TURBOyan/Turbo_Ctrl/README.md

## 1、开源仓库地址

	https://github.com/TURBOyan/Turbo_Ctrl.git
