TURBOyan/Turbo_Ctrl/2-Hardware/TurboCtrl_PCB/output/V1.2.0/TurboCtrl-v1.2.0.pdf

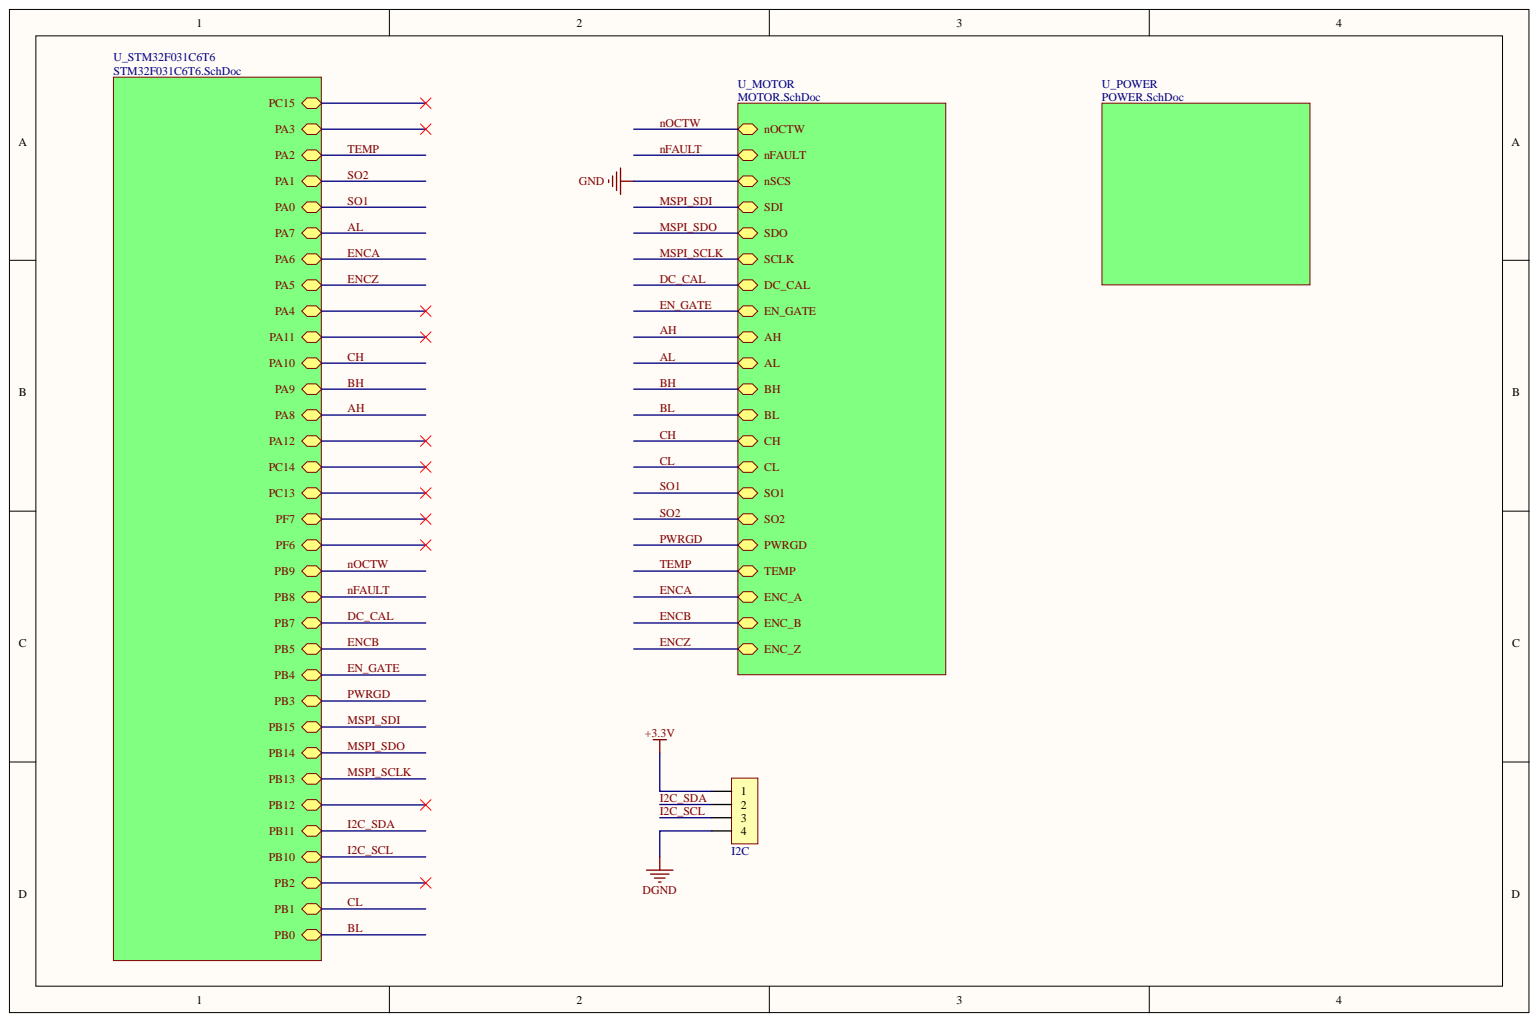
[picture p1: page 1]

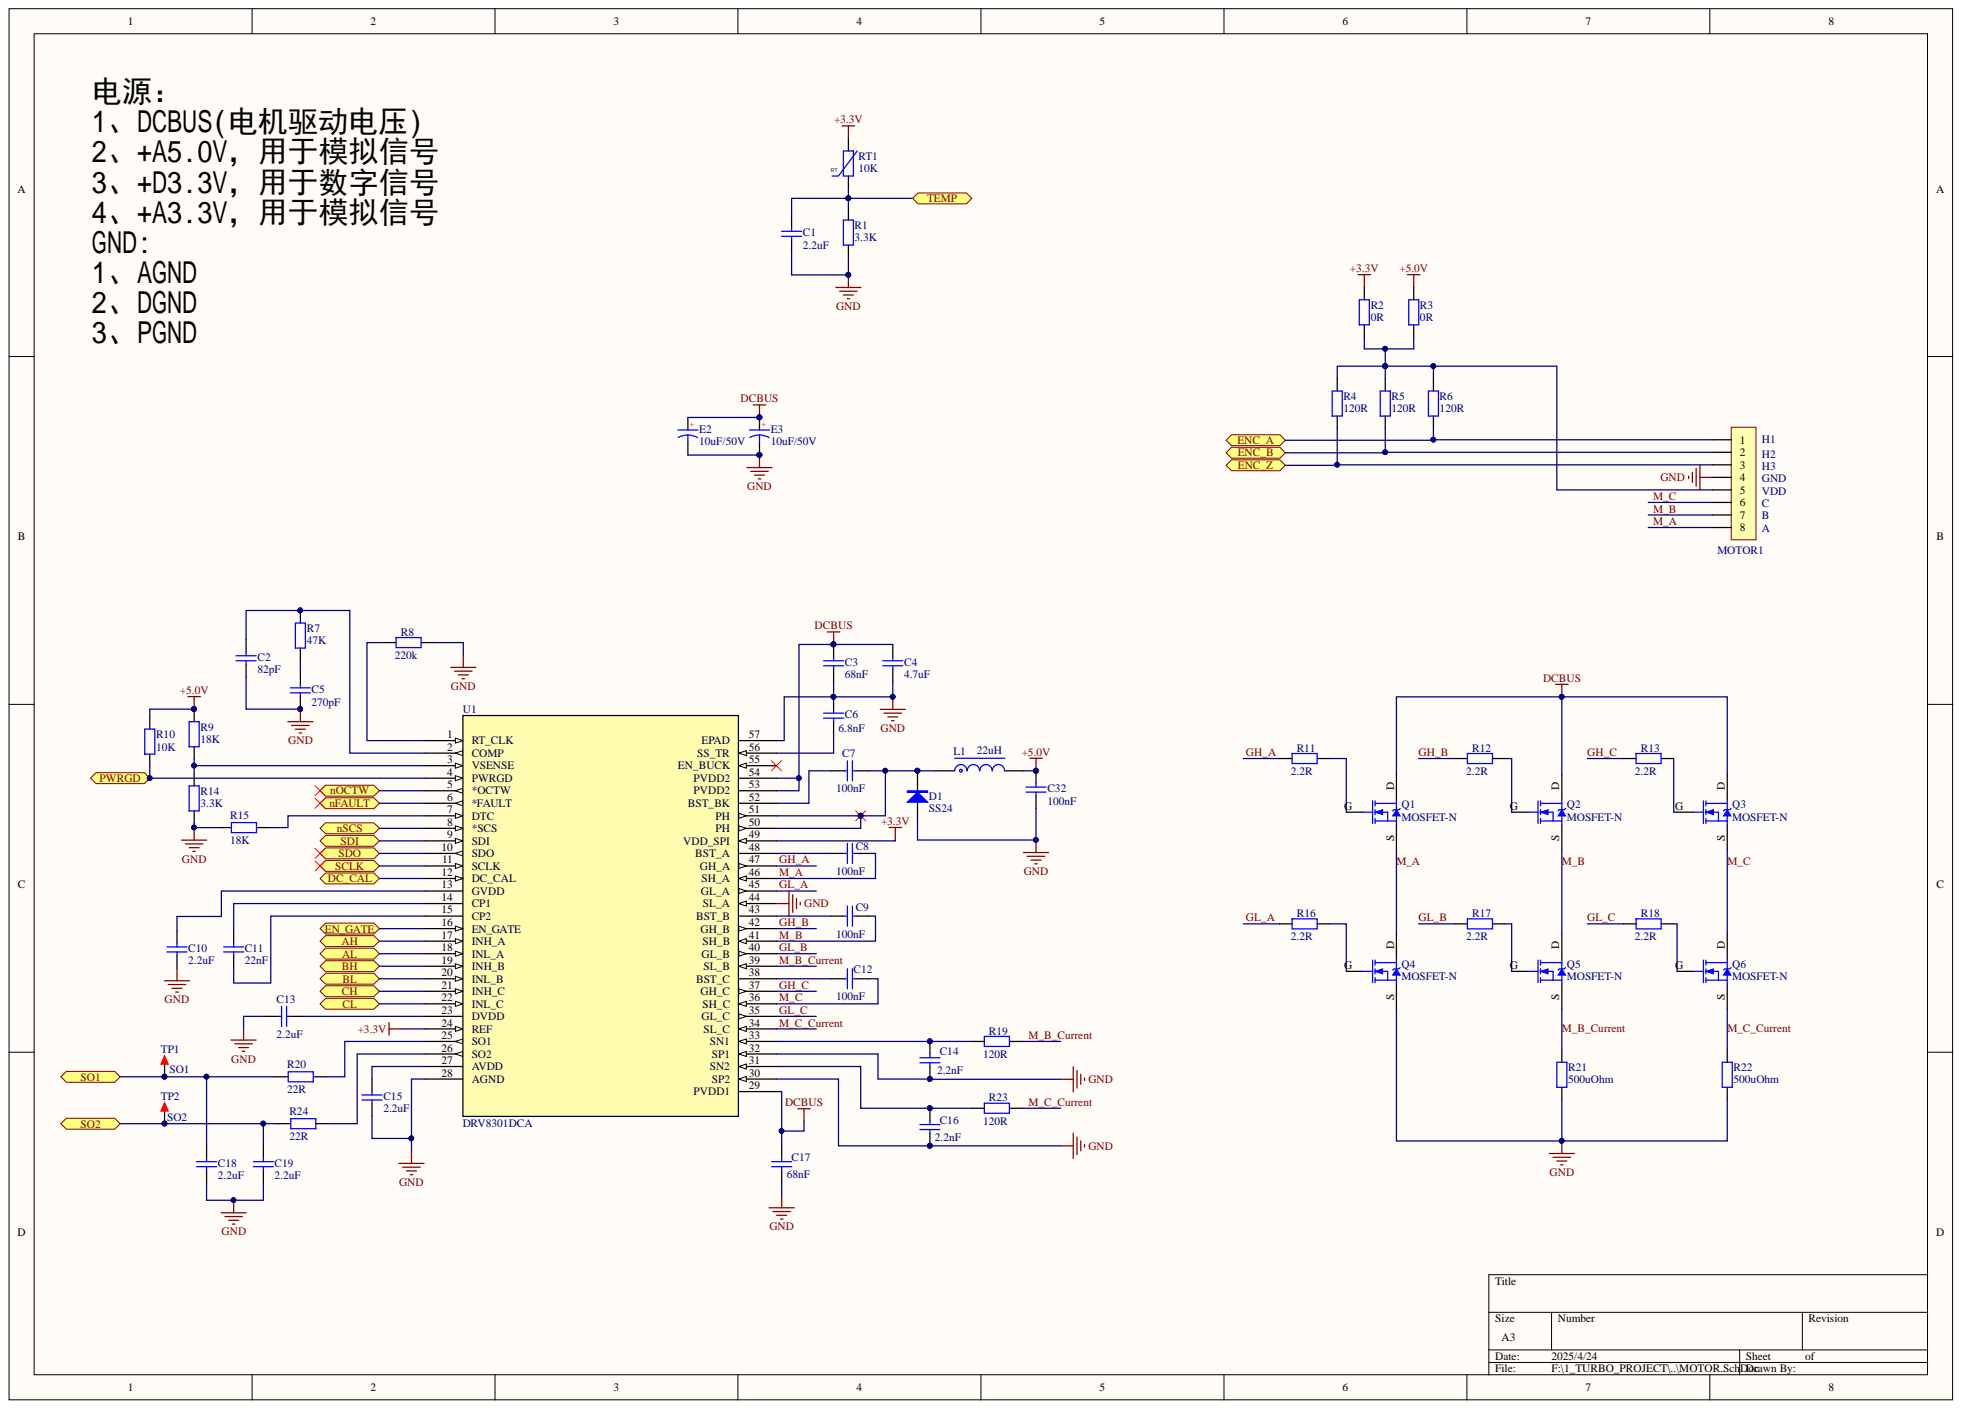
[picture p2: page 2]

SDO 10 | | C8

GVDD 13 | GL_A

SO2 26 AVDD 27

AGND 28 | 2.2nF

ECT\..\MOTOR.SchDoc Drawn By:

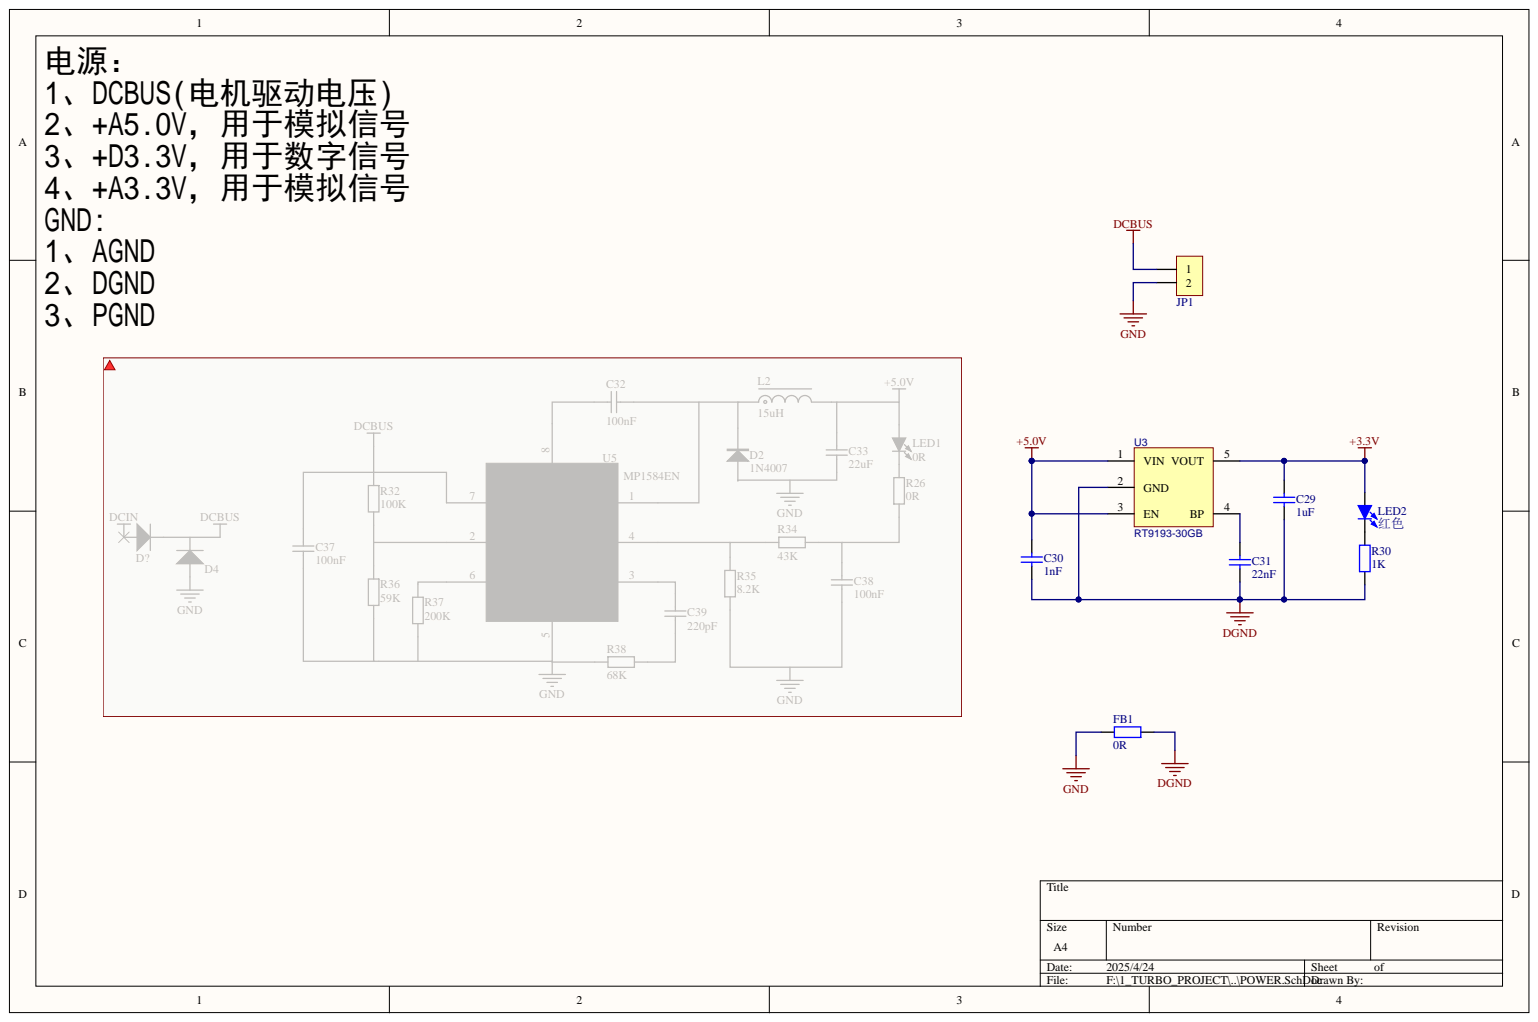
[picture p3: page 3]

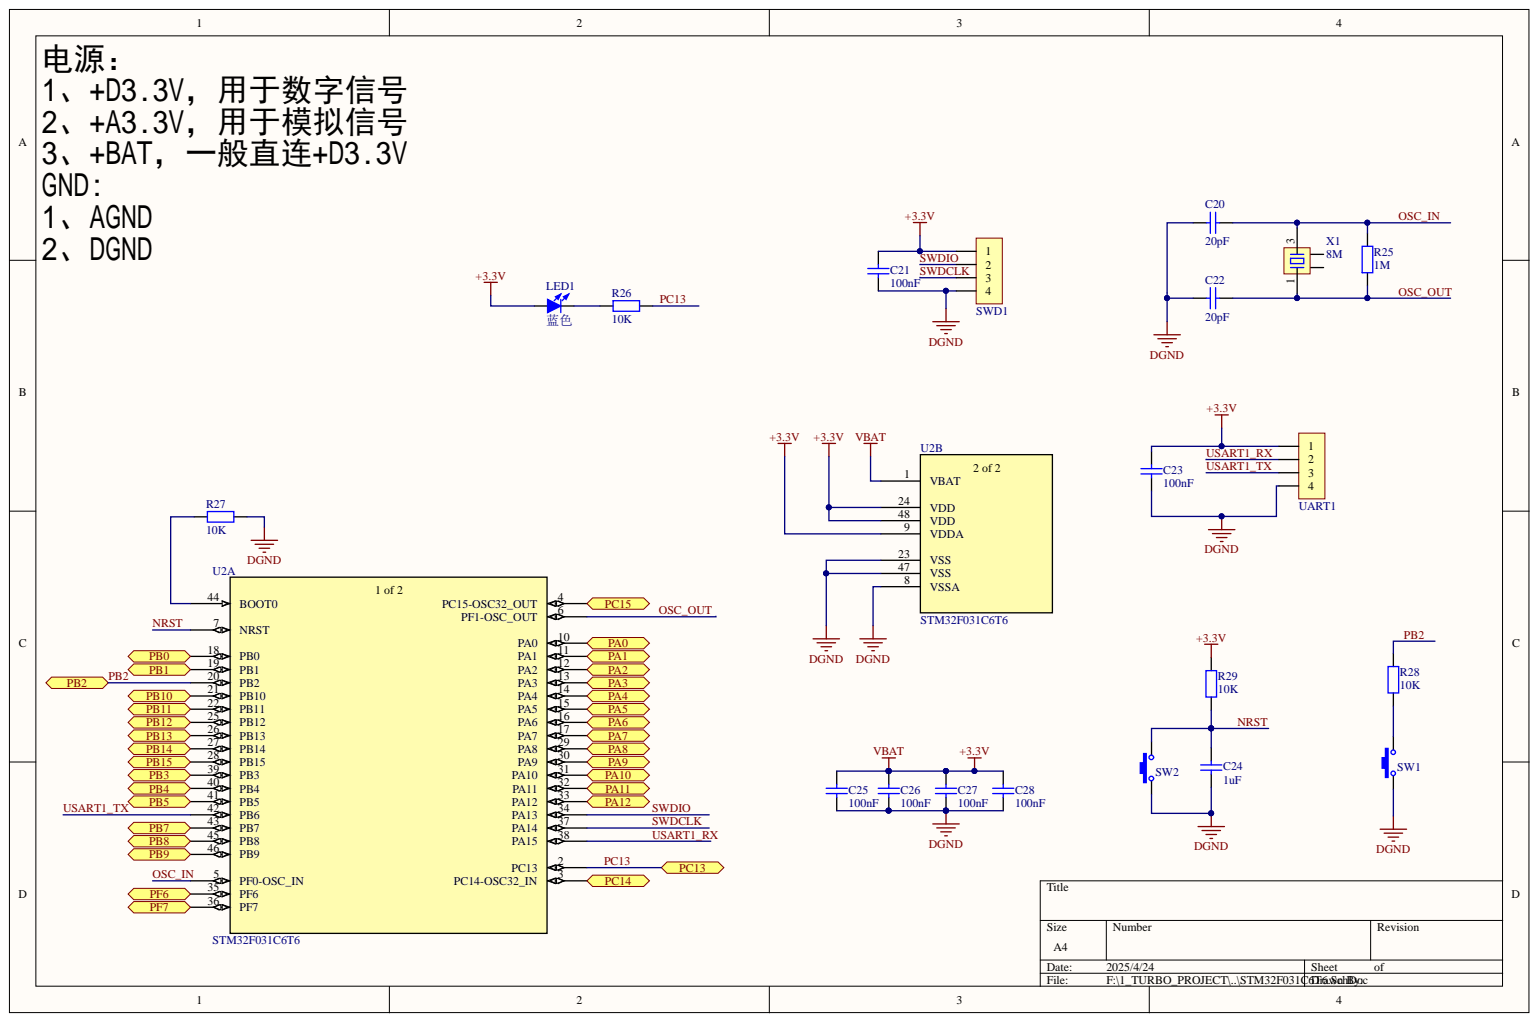
[picture p4: page 4]

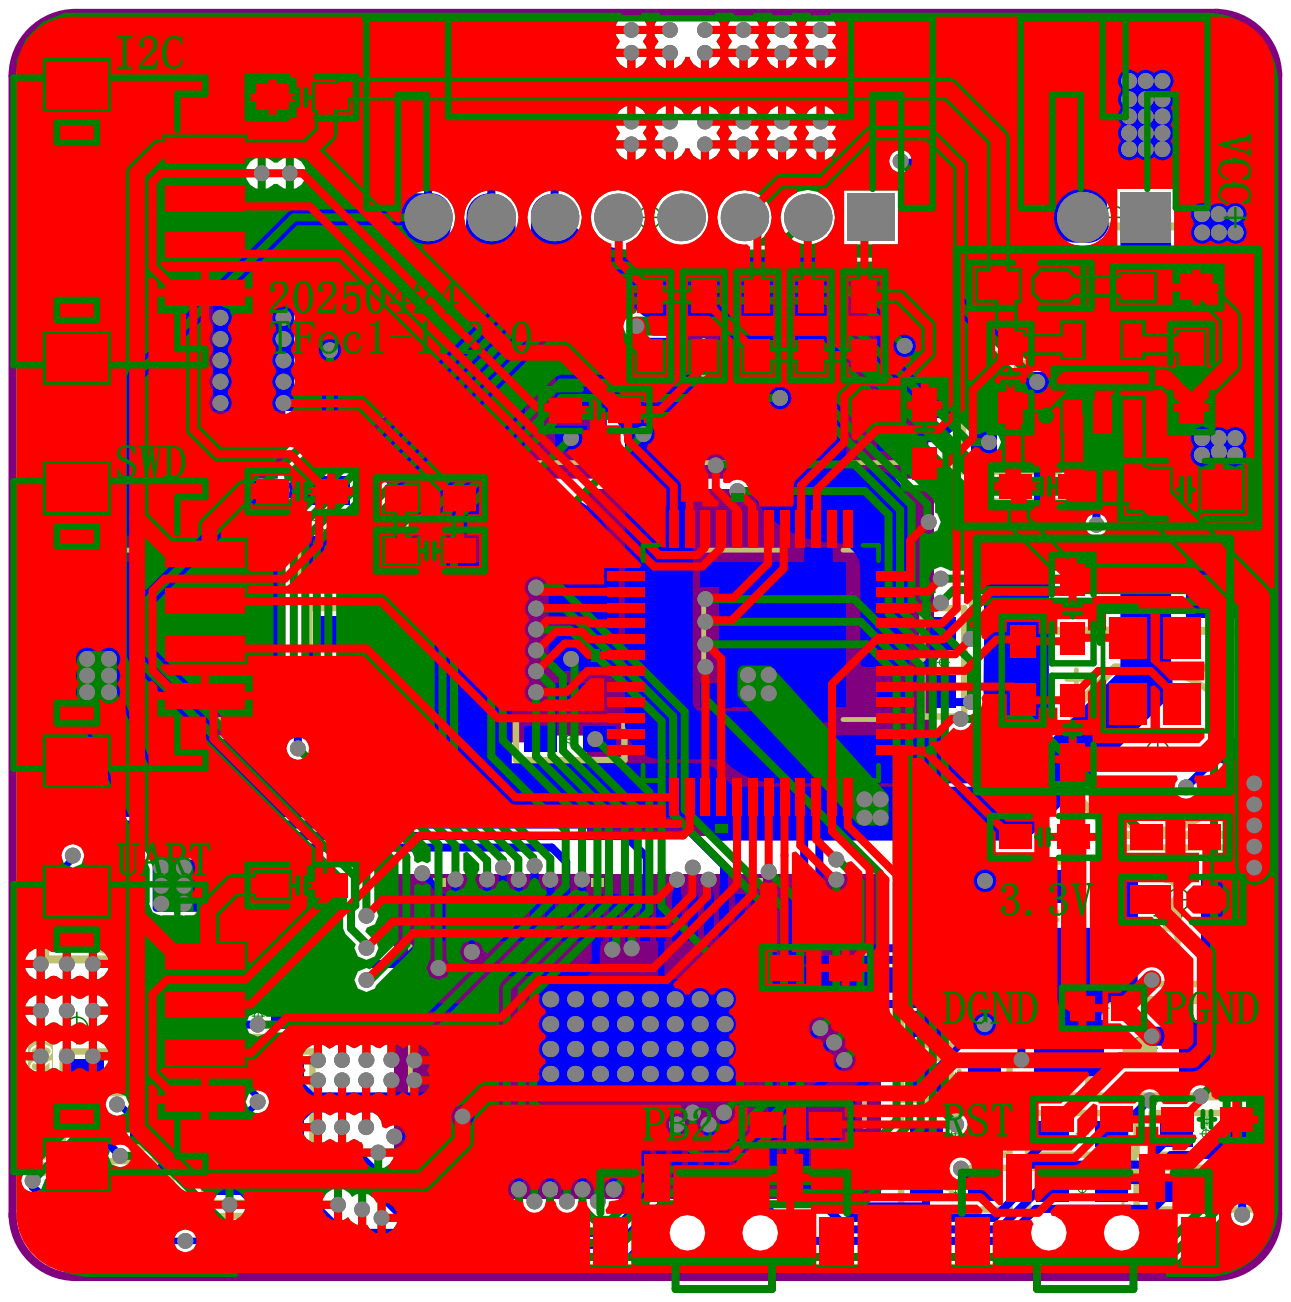
[picture p5: page 5]

Comment | Description | Designator | Footprint | LibRef | Quantity
2.2uF | 贴片电容/MLCC电容C1 | | C0603_M | C | 1
82pF | 贴片电容/MLCC电容C2 | | C0603_M | C | 1
68nF | 贴片电容/MLCC电容C3 | | C0603_M | C | 1
4.7uF | 贴片电容/MLCC电容C4 | | C0603_M | C | 1
270pF | 贴片电容/MLCC电容C5 | | C0603_M | C | 1
6.8nF | 贴片电容/MLCC电容C6 | | C0603_M | C | 1
100nF | 贴片电容/MLCC电容C7 | | C0603_M | C | 1
100nF | 贴片电容/MLCC电容C8 | | C0603_M | C | 1
100nF | 贴片电容/MLCC电容C9 | | C0603_M | C | 1
2.2uF | 贴片电容/MLCC电容C10 | | C0603_M | C | 1
22nF | 贴片电容/MLCC电容C11 | | C0603_M | C | 1
100nF | 贴片电容/MLCC电容C12 | | C0603_M | C | 1
2.2uF | 贴片电容/MLCC电容C13 | | C0603_M | C | 1
2.2nF | 贴片电容/MLCC电容C14 | | C0603_M | C | 1
2.2uF | 贴片电容/MLCC电容C15 | | C0603_M | C | 1
2.2nF | 贴片电容/MLCC电容C16 | | C0603_M | C | 1
68nF | 贴片电容/MLCC电容C17 | | C0603_M | C | 1
2.2uF | 贴片电容/MLCC电容C18 | | C0603_M | C | 1
2.2uF | 贴片电容/MLCC电容C19 | | C0603_M | C | 1
20pF | 贴片电容/MLCC电容C20 | | C0603_M | C | 1
100nF | 贴片电容/MLCC电容C21 | | C0603_M | C | 1
20pF | 贴片电容/MLCC电容C22 | | C0603_M | C | 1
100nF | 贴片电容/MLCC电容C23 | | C0603_M | C | 1
1uF | 贴片电容/MLCC电容C24 | | C0603_M | C | 1
100nF | 贴片电容/MLCC电容C25 | | C0603_M | C | 1
100nF | 贴片电容/MLCC电容C26 | | C0603_M | C | 1
100nF | 贴片电容/MLCC电容C27 | | C0603_M | C | 1
100nF | 贴片电容/MLCC电容C28 | | C0603_M | C | 1
1uF | 贴片电容/MLCC电容C29 | | C0603_M | C | 1
1nF | 贴片电容/MLCC电容C30 | | C0603_M | C | 1
22nF | 贴片电容/MLCC电容C31 | | C0603_M | C | 1
100nF | 贴片电容/MLCC电容C32 | | C0805_M | C | 1
SS24 | 整流二极管 | D1 | SMA | 1N4007 | 1
10uF/50V | 贴片电解电容 | E2 | CE C(5*5.4) | CE_SMD | 1
10uF/50V | 贴片电解电容 | E3 | CE C(5*5.4) | CE_SMD | 1
0R | 贴片电阻 | FB1 | R0603_L | R | 1
HDR-1X4 | 4P接插件 | I2C | ZH1.5-WS-4P | Header 4 | 1
HDR-1X2 | 2P接插件 | JP1 | PH2.0-W-2P | Header 2 | 1
22uH | 一体成型电感 | L1 | L-SMD-0420 | L-Molding Choke | 1
蓝色 | 贴片LED | LED1 | LED0603_B | LED-SMD | 1
红色 | 贴片LED | LED2 | LED0603_R | LED-SMD | 1
HDR-1X8 | 8P接插件 | MOTOR1 | PH2.0-W-8P | Header 8 | 1
MOSFET-N | N-Channel MOSFET | Q1 | DFN5_5X6_ONS | MOSFET-N | 1
MOSFET-N | N-Channel MOSFET | Q2 | DFN5_5X6_ONS | MOSFET-N | 1
MOSFET-N | N-Channel MOSFET | Q3 | DFN5_5X6_ONS | MOSFET-N | 1
MOSFET-N | N-Channel MOSFET | Q4 | DFN5_5X6_ONS | MOSFET-N | 1
MOSFET-N | N-Channel MOSFET | Q5 | DFN5_5X6_ONS | MOSFET-N | 1
MOSFET-N | N-Channel MOSFET | Q6 | DFN5_5X6_ONS | MOSFET-N | 1
3.3K | 贴片电阻 | R1 | R0603_M | R | 1
0R | 贴片电阻 | R2 | R0603_M | R | 1
0R | 贴片电阻 | R3 | R0603_M | R | 1
120R | 贴片电阻 | R4 | R0603_M | R | 1
120R | 贴片电阻 | R5 | R0603_M | R | 1
120R | 贴片电阻 | R6 | R0603_M | R | 1
47K | 贴片电阻 | R7 | R0603_M | R | 1
220k | 贴片电阻 | R8 | R0603_M | R | 1
18K | 贴片电阻 | R9 | R0603_M | R | 1
10K | 贴片电阻 | R10 | R0603_M | R | 1
2.2R | 贴片电阻 | R11 | R0603_M | R | 1
2.2R | 贴片电阻 | R12 | R0603_M | R | 1
2.2R | 贴片电阻 | R13 | R0603_M | R | 1
3.3K | 贴片电阻 | R14 | R0603_M | R | 1
18K | 贴片电阻 | R15 | R0603_M | R | 1
2.2R | 贴片电阻 | R16 | R0603_M | R | 1
2.2R | 贴片电阻 | R17 | R0603_M | R | 1
2.2R | 贴片电阻 | R18 | R0603_M | R | 1
120R | 贴片电阻 | R19 | R0603_M | R | 1
22R | 贴片电阻 | R20 | R0603_M | R | 1
500uOhm | 贴片电阻 | R21 | R2512_M | R | 1
500uOhm | 贴片电阻 | R22 | R2512_M | R | 1
120R | 贴片电阻 | R23 | R0603_M | R | 1
22R | 贴片电阻 | R24 | R0603_M | R | 1
1M | 贴片电阻 | R25 | R0603_M | R | 1
10K | 贴片电阻 | R26 | R0603_M | R | 1
10K | 贴片电阻 | R27 | R0603_M | R | 1
10K | 贴片电阻 | R28 | R0603_M | R | 1
10K | 贴片电阻 | R29 | R0603_M | R | 1
1K | 贴片电阻 | R30 | R0603_M | R | 1
10K | 热敏电阻 | RT1 | R0805-HP_L | RT | 1
3x6x5 | 3x6轻触开关 | SW1 | SW 3*6*4.3-S-W | SW 3x6 | 1
3x6x5 | 3x6轻触开关 | SW2 | SW 3*6*4.3-S-W | SW 3x6 | 1
HDR-1X4 | 4P接插件 | SWD1 | ZH1.5-WS-4P | Header 4 | 1
SO1 | 测试点 | TP1 | TEST 0.8 | TEST | 1
SO2 | 测试点 | TP2 | TEST 0.8 | TEST | 1
DRV8301DCA | No Description Available U1 | | DRV8301DCA | DRV8301DCA | 1
STM32F031C6T6 | No Description Available U2 | | LQFP48-7x7mm | STM32F031C6T6 | 1
RT9193-30GB | LDO 3.0V/0.3A | U3 | SOT-23-5 | RT9193-30GB | 1
HDR-1X4 | 4P接插件 | UART1 | ZH1.5-WS-4P | Header 4 | 1
8M | 4脚无源晶振(谐振器）X1 | | XTAL-3225-4P | XTAL-4P | 1
