TURBOyan/Turbo_Ctrl/(list of files, drawings)

Other design files:
2-Hardware/TurboCtrl_PCB/PCB/TurboCtrl.PcbDoc
2-Hardware/TurboCtrl_PCB/schematic/MAIN.SchDoc
2-Hardware/TurboCtrl_PCB/schematic/MOTOR.SchDoc
2-Hardware/TurboCtrl_PCB/schematic/POWER.SchDoc
2-Hardware/TurboCtrl_PCB/schematic/STM32F031C6T6.SchDoc
2-Hardware/TurboCtrl_PCB/schematic/W806.SchDoc
2-Hardware/TurboCtrl_PCB/TurboCtrl.PrjPCB
