TURBOyan/Turbo_Ctrl/1-Firmware/STM32_Code/Core/Src/main.c

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
/* Includes ------------------------------------------------------------------*/
#include "main.h"
#include "adc.h"
#include "i2c.h"
#include "spi.h"
#include "tim.h"
#include "usart.h"
#include "gpio.h"

/* USER CODE BEGIN Includes */
#include "drv8301.h"
#include "utils.h"
/* USER CODE END Includes */


void SystemClock_Config(void);
/**
  * @brief  The application entry point.
  * @retval int
  */
int main(void)
{

  /* MCU Configuration--------------------------------------------------------*/

  /* Reset of all peripherals, Initializes the Flash interface and the Systick. */
  HAL_Init();

  /* Configure the system clock */
  SystemClock_Config();

  /* Initialize all configured peripherals */
  MX_GPIO_Init();
  MX_ADC_Init();
  MX_I2C1_Init();
  MX_SPI1_Init();
  MX_USART1_UART_Init();
  MX_TIM1_Init();
  /* USER CODE BEGIN 2 */
  __HAL_TIM_SetCompare(&htim1, TIM_CHANNEL_1, 50);
  __HAL_TIM_SetCompare(&htim1, TIM_CHANNEL_2, 50);
  __HAL_TIM_SetCompare(&htim1, TIM_CHANNEL_3, 50);

  int16_t ret = 0;
  RegisterFile regs_;
  ret = DRV8301_Config(&regs_, 40.0f, NULL);
  if (ret != 0)
  {
    printf("DRV8301_Config Err:%d\r\n", ret);
  }
  ret = DRV8301_Init(&regs_);
  if (ret != 0)
  {
    printf("DRV8301_Init Err:%d\r\n", ret);
  }

  /* USER CODE END 2 */

  /* Infinite loop */
  /* USER CODE BEGIN WHILE */
  while (1)
  {
    /* USER CODE END WHILE */

    /* USER CODE BEGIN 3 */
    DRV8301_Motor_test(1);
    // HAL_GPIO_TogglePin(LED_GPIO_Port, LED_Pin);
		// HAL_Delay(1*1000);
  }
  /* USER CODE END 3 */
}

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
/* USER CODE BEGIN 4 */
void HAL_GPIO_EXTI_Callback(uint16_t GPIO_Pin)
{
    if (GPIO_Pin == GPIO_PIN_2)
    {
        //HAL_GPIO_TogglePin(LED_GPIO_Port, LED_Pin);
				printf("start:%d\r\n",HAL_GetTick());
//				if(motor_status)
//				{
//					motor_status=0;
//					HAL_GPIO_WritePin(LED_GPIO_Port, LED_Pin, GPIO_PIN_SET);
//				}
//				else
//				{
//					motor_status=1;
//					HAL_GPIO_WritePin(LED_GPIO_Port, LED_Pin, GPIO_PIN_RESET);
//				}
				printf("end:%d fault:%d\r\n",HAL_GetTick(),HAL_GPIO_ReadPin(FAULT_GPIO_Port, FAULT_Pin));
    }
}
/* USER CODE END 4 */
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
