TURBOyan/Turbo_Ctrl/1-Firmware/STM32_Code/Core/Inc/main.h

#define LED_Pin GPIO_PIN_13
#define LED_GPIO_Port GPIOC
#define SPI_CS_Pin GPIO_PIN_3
#define SPI_CS_GPIO_Port GPIOA
#define ENC_Z_Pin GPIO_PIN_5
#define ENC_Z_GPIO_Port GPIOA
#define AL_Pin GPIO_PIN_7
#define AL_GPIO_Port GPIOA
#define BL_Pin GPIO_PIN_0
#define BL_GPIO_Port GPIOB
#define CL_Pin GPIO_PIN_1
#define CL_GPIO_Port GPIOB
#define BUTTON_Pin GPIO_PIN_2
#define BUTTON_GPIO_Port GPIOB
#define BUTTON_EXTI_IRQn EXTI2_3_IRQn
#define EN_GATE_Pin GPIO_PIN_4
#define EN_GATE_GPIO_Port GPIOB
#define FAULT_Pin GPIO_PIN_8
#define FAULT_GPIO_Port GPIOB
