TURBOyan/Turbo_Ctrl/1-Firmware/STM32_Code/APP/src/utils.c

#include "utils.h"
#include "stm32f0xx_hal.h"

__STATIC_INLINE uint32_t GXT_SYSTICK_IsActiveCounterFlag(void)
{
  return ((SysTick->CTRL & SysTick_CTRL_COUNTFLAG_Msk) == (SysTick_CTRL_COUNTFLAG_Msk));
}
static uint32_t getCurrentMicros(void)
{
  /* Ensure COUNTFLAG is reset by reading SysTick control and status register */
  GXT_SYSTICK_IsActiveCounterFlag();
  uint32_t m = HAL_GetTick();
  const uint32_t tms = SysTick->LOAD + 1;
  __IO uint32_t u = tms - SysTick->VAL;
  if (GXT_SYSTICK_IsActiveCounterFlag())
  {
    m = HAL_GetTick();
    u = tms - SysTick->VAL;
  }
  return (m * 1000 + (u * 1000) / tms);
}
// 获取系统时间，单位us
uint32_t micros(void)
{
  return getCurrentMicros();
}

// @brief: Busy wait delay for given amount of microseconds (us)
void delay_us(uint32_t us)
{
  uint32_t start = micros();
  while (micros() - start < (uint32_t)us)
  {
    __ASM("nop");
  }
}
