TURBOyan/Turbo_Ctrl/(commit log)

2021-11-16 开始FOC项目
2021-11-20 增加freertos版本程序
2021-12-02 [ADD]增加W806的RTOS代码，完成STM32和半桥驱动部分电路
    [MAIN.SchDoc, MOTOR.SchDoc, STM32F031C6T6.SchDoc, TurboCtrl.PrjPCB]
2021-12-02 [ADD]增加readme文件
2021-12-02 [ADD]增加gitignore文件
2021-12-02 [ADD]增加W806原理图，封装已准备
    [MAIN.SchDoc, MOTOR.SchDoc, TurboCtrl.PrjPCB, W806.SchDoc]
2021-12-02 [CHG]绘制W806原理图
    [W806.SchDoc]
2021-12-02 [CHG]修改806原理图
    [W806.SchDoc]
2021-12-02 修改W806原理图
    [W806.SchDoc]
2021-12-09 [ADD]增加W801示例代码
    [MAIN.SchDoc, MOTOR.SchDoc, TurboCtrl.PrjPCB, W806.SchDoc]
2021-12-13 更新readme文档，保存github路径
2021-12-29 增加电源部分原理图
    [MAIN.SchDoc, POWER.SchDoc, TurboCtrl.PrjPCB, W806.SchDoc]
2022-02-21 [CHG]完成电源子模块
    [MAIN.SchDoc, MOTOR.SchDoc, POWER.SchDoc]
2022-03-14 [ADD]增加天线部分，修复W806引脚标号错误
    [MAIN.SchDoc, W806.SchDoc]
2022-05-06 [CHG]连接32和BLDC的引脚
    [MAIN.SchDoc, STM32F031C6T6.SchDoc]
2022-06-28 [CHG]完成原理图引脚配置，待配置封装种类
    [MAIN.SchDoc, MOTOR.SchDoc, POWER.SchDoc, STM32F031C6T6.SchDoc, TurboCtrl.PrjPCB]
2022-07-10 [CHG]完成元件封装配置
    [MAIN.SchDoc, MOTOR.SchDoc, POWER.SchDoc, STM32F031C6T6.SchDoc, TurboCtrl.PcbDoc]
2022-08-08 [CHG]完成驱动部分元件摆放
    [MAIN.SchDoc, MOTOR.SchDoc, POWER.SchDoc, STM32F031C6T6.SchDoc, TurboCtrl.PcbDoc, TurboCtrl.PrjPCB]
2022-08-08 [CHG]完成无刷接口部分布线，待添加缝合孔
    [TurboCtrl.PcbDoc]
2022-08-09 [CHG]修复部分网络标号冲突问题
    [MAIN.SchDoc, MOTOR.SchDoc, POWER.SchDoc, STM32F031C6T6.SchDoc, TurboCtrl.PcbDoc]
2022-08-11 [CHG]调换电机接口方向；增加XT60接口焊盘
    [MOTOR.SchDoc, POWER.SchDoc, TurboCtrl.PcbDoc]
2022-08-16 [CHG]完成电源一级降压部分布线
    [TurboCtrl.PcbDoc]
2022-08-16 [CHG]器件摆放完成，待布线完成
    [STM32F031C6T6.SchDoc, TurboCtrl.PcbDoc]
2022-08-17 [CHG]完成全部器件摆放，待完成布线
    [STM32F031C6T6.SchDoc, TurboCtrl.PcbDoc]
2022-08-20 [CHG]统一电源，小板去除数字模拟分离
    [MAIN.SchDoc, MOTOR.SchDoc, POWER.SchDoc, STM32F031C6T6.SchDoc, TurboCtrl.PcbDoc]
2022-08-26 [CHG]完成大部分布线
    [POWER.SchDoc, TurboCtrl.PcbDoc]
2022-08-28 [CHG]完成所有布线，待铺铜及添加丝印
    [MAIN.SchDoc, MOTOR.SchDoc, TurboCtrl.PcbDoc]
2022-08-28 [CHG]完成所有布线，待铺铜
    [MOTOR.SchDoc, TurboCtrl.PcbDoc]
2025-03-18 修改Header4的封装为ZH1.5；修改UART引脚顺序
    [MAIN.SchDoc, POWER.SchDoc, STM32F031C6T6.SchDoc, TurboCtrl.PrjPCB]
2025-03-18 修复线距离板子边缘过近问题，发板TFoc1-1.1.1
2025-04-12 [CHG]第二版原理图修改完成
    [MAIN.SchDoc, MOTOR.SchDoc, POWER.SchDoc, STM32F031C6T6.SchDoc]
2025-04-15 主要拉线完成，待完成细节
    [MAIN.SchDoc, MOTOR.SchDoc, POWER.SchDoc, TurboCtrl.PrjPCB]
2025-04-23 完成Foc1-1.2.0布线
    [MOTOR.SchDoc, TurboCtrl.PcbDoc, TurboCtrl.PrjPCB]
2025-04-23 新增成果物
2025-04-23 修改dev8301的大GND未连接问题
    [TurboCtrl.PcbDoc]
2025-04-23 更新成果物
    [TurboCtrl.PcbDoc]
2025-05-08 [CHG][CODE][HWV1.2.0]完成DRV8301的SPI配置功能
2025-05-11 解决SPI高速无法通信问题
2025-05-11 修改工程为vscode+openocd，并支持JLINK-SWD
2025-05-11 格式化代码
2025-05-13 [CHG]六步换向无感开环完成
2025-05-17 [DEL]删除无关代码
